energiegedrag-nl/needforheat-p1-base-hardware/docs/checks/4-gerber-netlist.txt

gerber primitives F 1854, B 426; copper islands F 94, B 45; plated holes 273
pads not on any copper: none
pads in board but not in schematic netlist: none
schematic nets checked: 47; derived copper nets: 47
OPENS: none
SHORTS: none
