energiegedrag-nl/needforheat-p1-base-hardware/docs/images/p1-base-v3-bottom.png

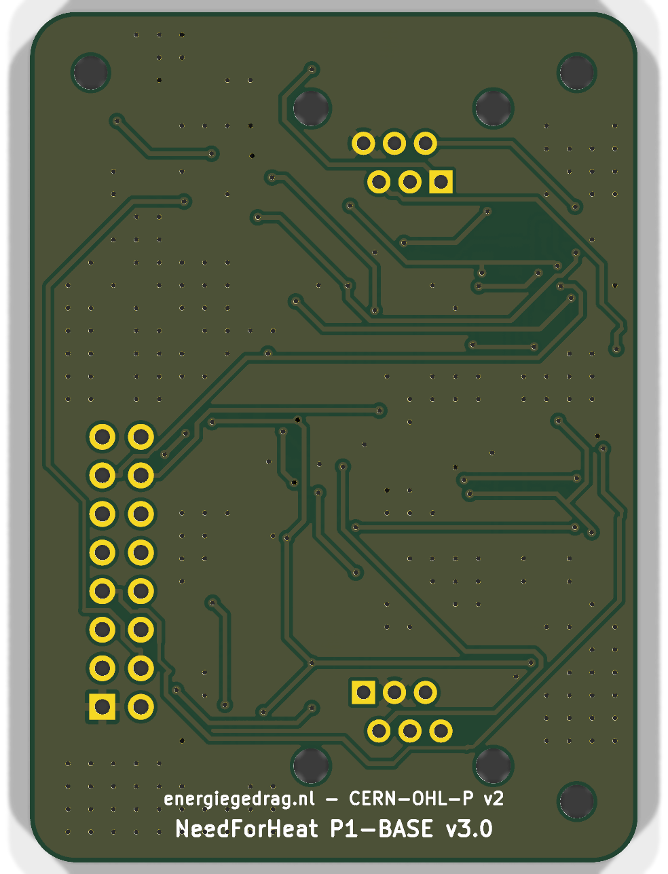
docs/images/p1-base-v3-bottom.png
