energiegedrag-nl/needforheat-p1-base-hardware/docs/images/p1-base-v3-side.png

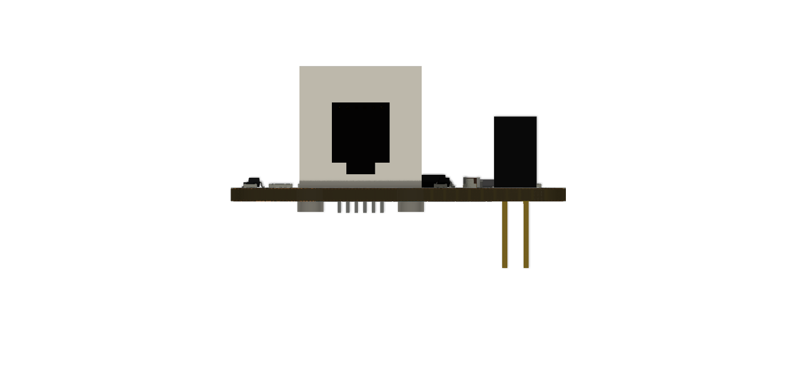
docs/images/p1-base-v3-side.png
