energiegedrag-nl/needforheat-p1-base-hardware/pcb/jlcpcb/BOM-needforheat-p1-base-hardware.csv

Comment | Designator | Footprint | LCSC
1u | C1,C3 | C_0603_1608Metric | C15849
100n | C2,C4,C6 | C_0603_1608Metric | C14663
22n | C7 | C_0603_1608Metric | C21122
10u | C8,C9 | C_0805_2012Metric | C15850
SMF5.0A | D1 | D_SMF | C193402
BAT54C | D2 | SOT-23 | C37704
PESD5V0S1BB | D3,D4,D5,D6 | D_SOD-523 | C2687128
1N5819WS | D7 | D_SOD-323 | C191023
CoreInk bus | J1 | CoreInk_Bus_2x08_P2.54mm | C72555
RJ12 to meter / RJ12 existing reader | J2,J3 | RJ25_Wayconn_MJEA-660X1_Horizontal | C77859
LED green | LED1 | LED_0603_1608Metric | C12624
LED yellow | LED2 | LED_0603_1608Metric | C2287
LED red | LED3 | LED_0603_1608Metric | C2286
AO3401A | Q1,Q3,Q6 | SOT-23 | C15127
2N7002 | Q2,Q4,Q5,Q7,Q8 | SOT-23 | C8545
10k | R1,R13,R32 | R_0603_1608Metric | C25804
100R | R2,R8,R16 | R_0603_1608Metric | C22775
1k | R3,R11,R25,R29 | R_0603_1608Metric | C21190
4k7 | R4 | R_0603_1608Metric | C23162
47R | R5 | R_0603_1608Metric | C23182
2k2 | R7,R31 | R_0603_1608Metric | C4190
100k | R9,R10,R12,R14,R21,R23,R26,R30 | R_0603_1608Metric | C25803
47k | R18,R24 | R_0603_1608Metric | C25819
68k | R19,R22 | R_0603_1608Metric | C23231
3k3 | R20 | R_0603_1608Metric | C22978
20k | R27,R28 | R_0603_1608Metric | C4184
74LVC1G14 | U1 | SOT-23-5 | C7835
TP4056 | U3 | SOIC-8-1EP_3.9x4.9mm_P1.27mm_EP2.29x3mm | C16581
