energiegedrag-nl/needforheat-p1-base-hardware/enclosure/fabrication/p1-base-kuip.step

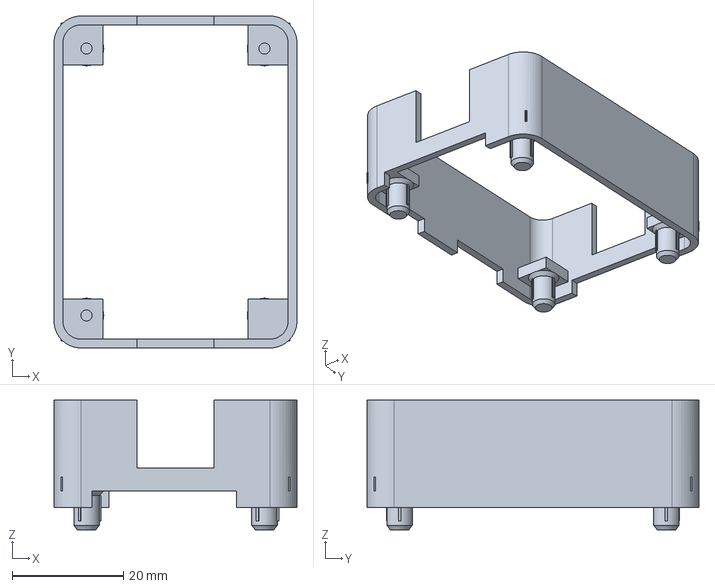
[picture p7: CAD file, 2026-11-14]
enclosure/fabrication/p1-base-kuip.step
43.7 x 59.7 x 23.3 mm
