energiegedrag-nl/needforheat-p1-base-hardware/enclosure/p1-base-v3-pcb.step

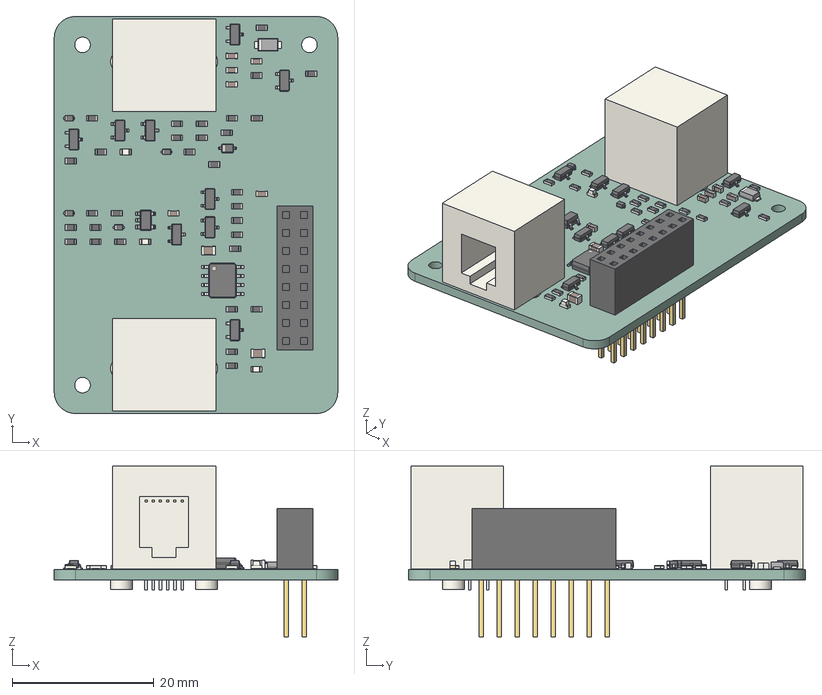
[picture p8: CAD file, 2026-11-14]
enclosure/p1-base-v3-pcb.step
40.0 x 56.0 x 24.1 mm
R_0603_1608Metric x 31
C_0603_1608Metric x 6
SOT-23 x 9
D_SOD_523 x 4
pins
D_SOD-323
C_0805_2012Metric x 2
LED_0603_1608Metric x 3
SOT-23-5
contacts x 2
legs x 2
posts x 2
D_SMF
SOIC-8-1EP_3.9x4.9mm_P1.27mm_EP2.29x3mm
needforheat-p1-base-hardware_PCB
