energiegedrag-nl/needforheat-p1-base-hardware/enclosure/fabrication/p1-base-lid.step

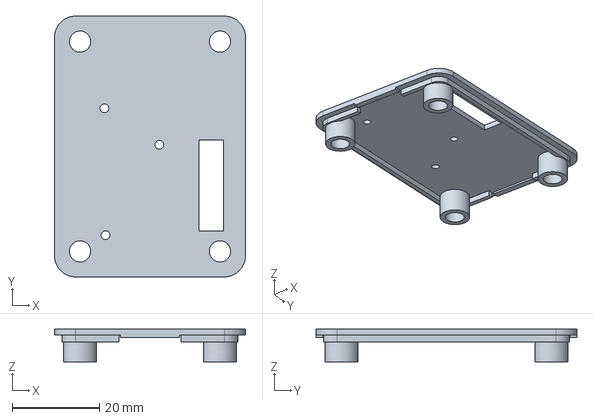
[picture p9: CAD file, 2026-11-14]
enclosure/fabrication/p1-base-lid.step
43.7 x 59.7 x 7.50 mm
