energiegedrag-nl/needforheat-p1-base-hardware/(list of files, cad)

Other CAD files:
enclosure/fabrication/p1-base-kuip.stl
enclosure/fabrication/p1-base-lid.stl
