energiegedrag-nl/needforheat-p1-base-hardware/docs/needforheat-p1-base-hardware-sch.pdf

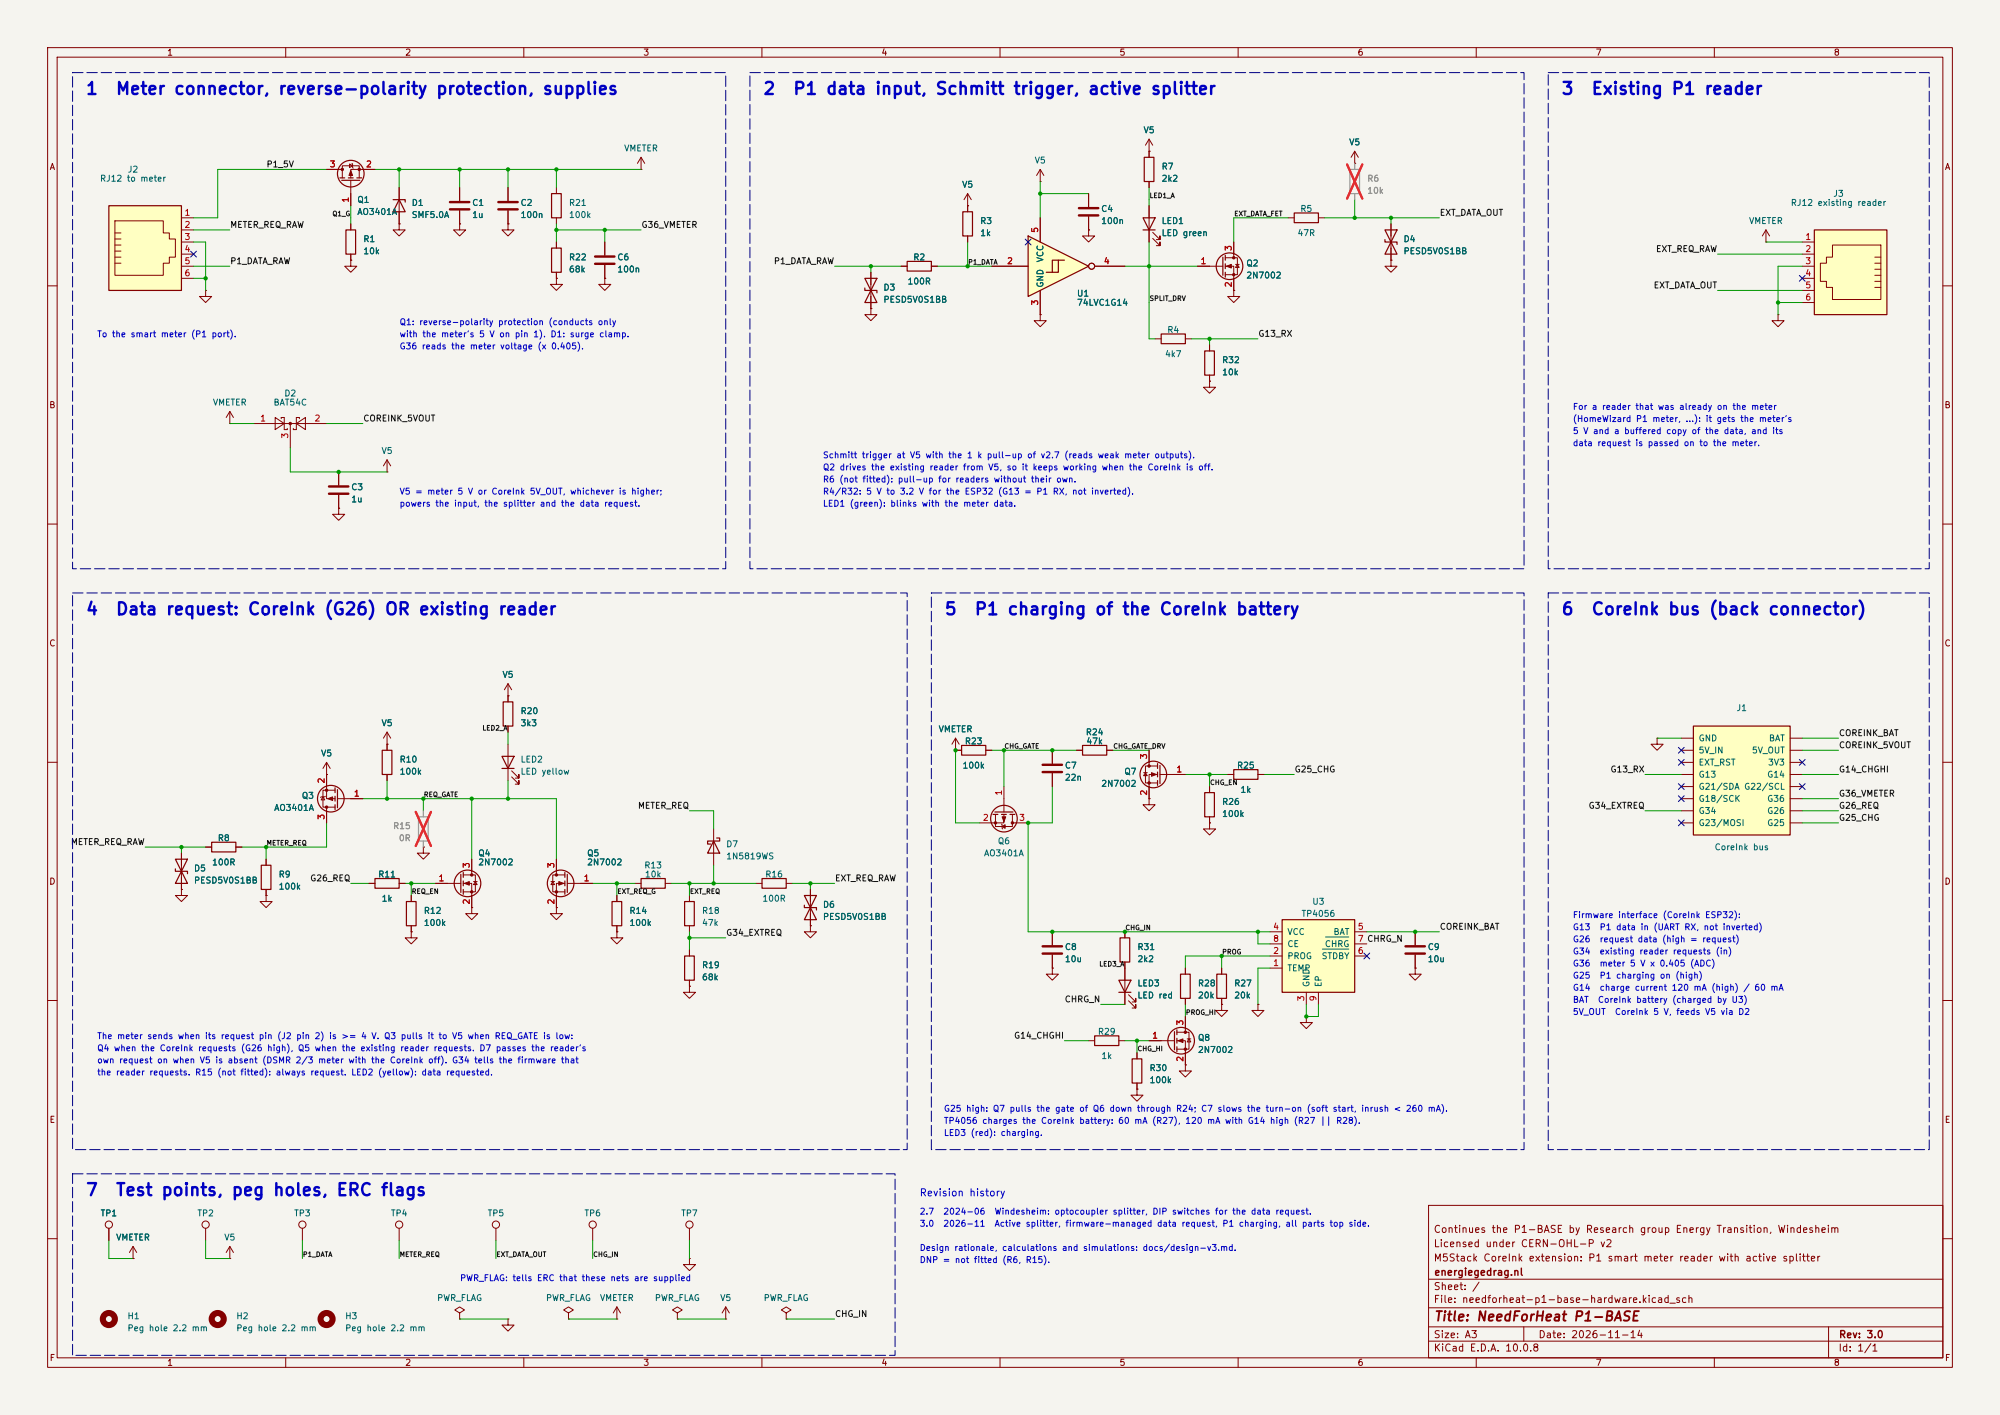
[picture p10: page 1]

R4/R32: 5 V to 3.2 V for the ESP32 (G13 = P1 RX, not inverted). Q1: reverse-polarity protection (conducts only with the meter's 5 V on pin 1). D1: surge clamp. G36 reads the meter voltage (x 0.405). V5 = meter 5 V or CoreInk 5V_OUT, whichever is higher; powers the input, the splitter and the data request.

To the smart meter (P1 port).

(HomeWizard P1 meter, ...): it gets the meter's For a reader that was already on the meter data request is passed on to the meter. 5 P1 charging of the CoreInk battery

5 V and a buffered copy of the data, and its G13 P1 data in (UART RX, not inverted) G26 request data (high = request) G34 existing reader requests (in) G36 meter 5 V x 0.405 (ADC) G25 P1 charging on (high) Firmware interface (CoreInk ESP32): G25 high: Q7 pulls the gate of Q6 down through R24; C7 slows the turn-on (soft start, inrush < 260 mA).

4 Data request: CoreInk (G26) OR existing reader

6 CoreInk bus (back connector)

Design rationale, calculations and simulations: docs/design-v3.md. LED3

G14 charge current 120 mA (high) / 60 mA

own request on when V5 is absent (DSMR 2/3 meter with the CoreInk off). G34 tells the firmware that
the reader requests. R15 (not fitted): always request. LED2 (yellow): data requested.

LED3 (red): charging. DNP = not fitted (R6, R15). TP4056 charges the CoreInk battery: 60 mA (R27), 120 mA with G14 high (R27 || R28).

7 Test points, peg holes, ERC flags

Revision history
2.7 2024-06 Windesheim: optocoupler splitter, DIP switches for the data request.
3.0 2026-11 Active splitter, firmware-managed data request, P1 charging, all parts top side.

Continues the P1-BASE by Research group Energy Transition, Windesheim
Licensed under CERN-OHL-P v2
M5Stack CoreInk extension: P1 smart meter reader with active splitter
energiegedrag.nl
Sheet: /
File: needforheat-p1-base-hardware.kicad_sch
Title: NeedForHeat P1-BASE

Size: A3 | Rev: 3.0 | F Date: 2026-11-14
KiCad E.D.A. 10.0.8 | Id: 1/1
