energiegedrag-nl/needforheat-p1-base-hardware/docs/needforheat-p1-base-hardware-pcb-bottom.pdf

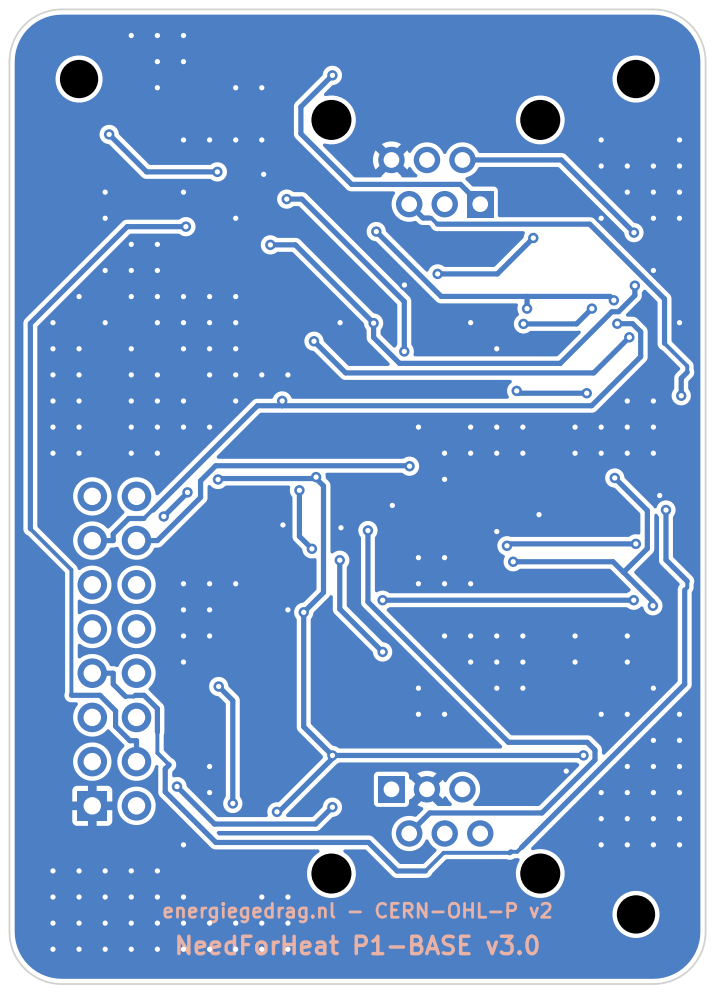
[picture p11: page 1]

energiegedrag.nl - CERN-OHL-P v2 NeedForHeat P1-BASE v3.0
