energiegedrag-nl/needforheat-p1-base-hardware/docs/needforheat-p1-base-hardware-pcb.pdf

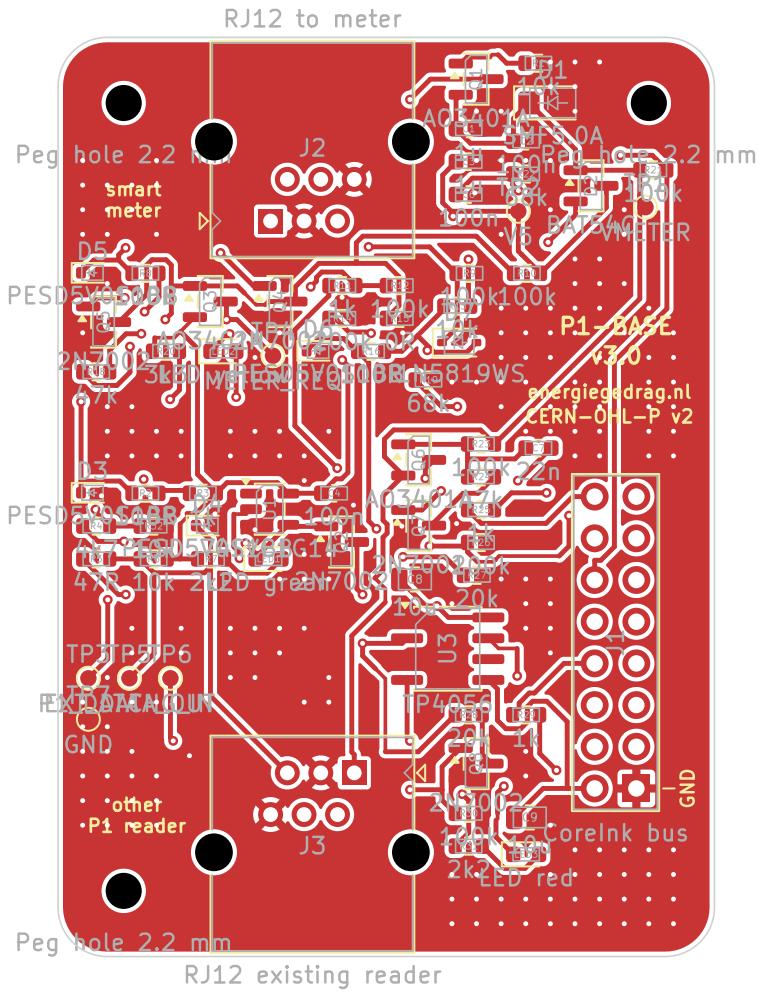
[picture p12: page 1]
