energiegedrag-nl/needforheat-p1-base-hardware/(list of files, drawings)

Other design files:
enclosure/pcb_features.json
