energiegedrag-nl/needforheat-p1-base-hardware/pcb/needforheat-p1-base-hardware.kicad_pcb

## KiCad design pcb/needforheat-p1-base-hardware.kicad_pcb (2026-11-14)

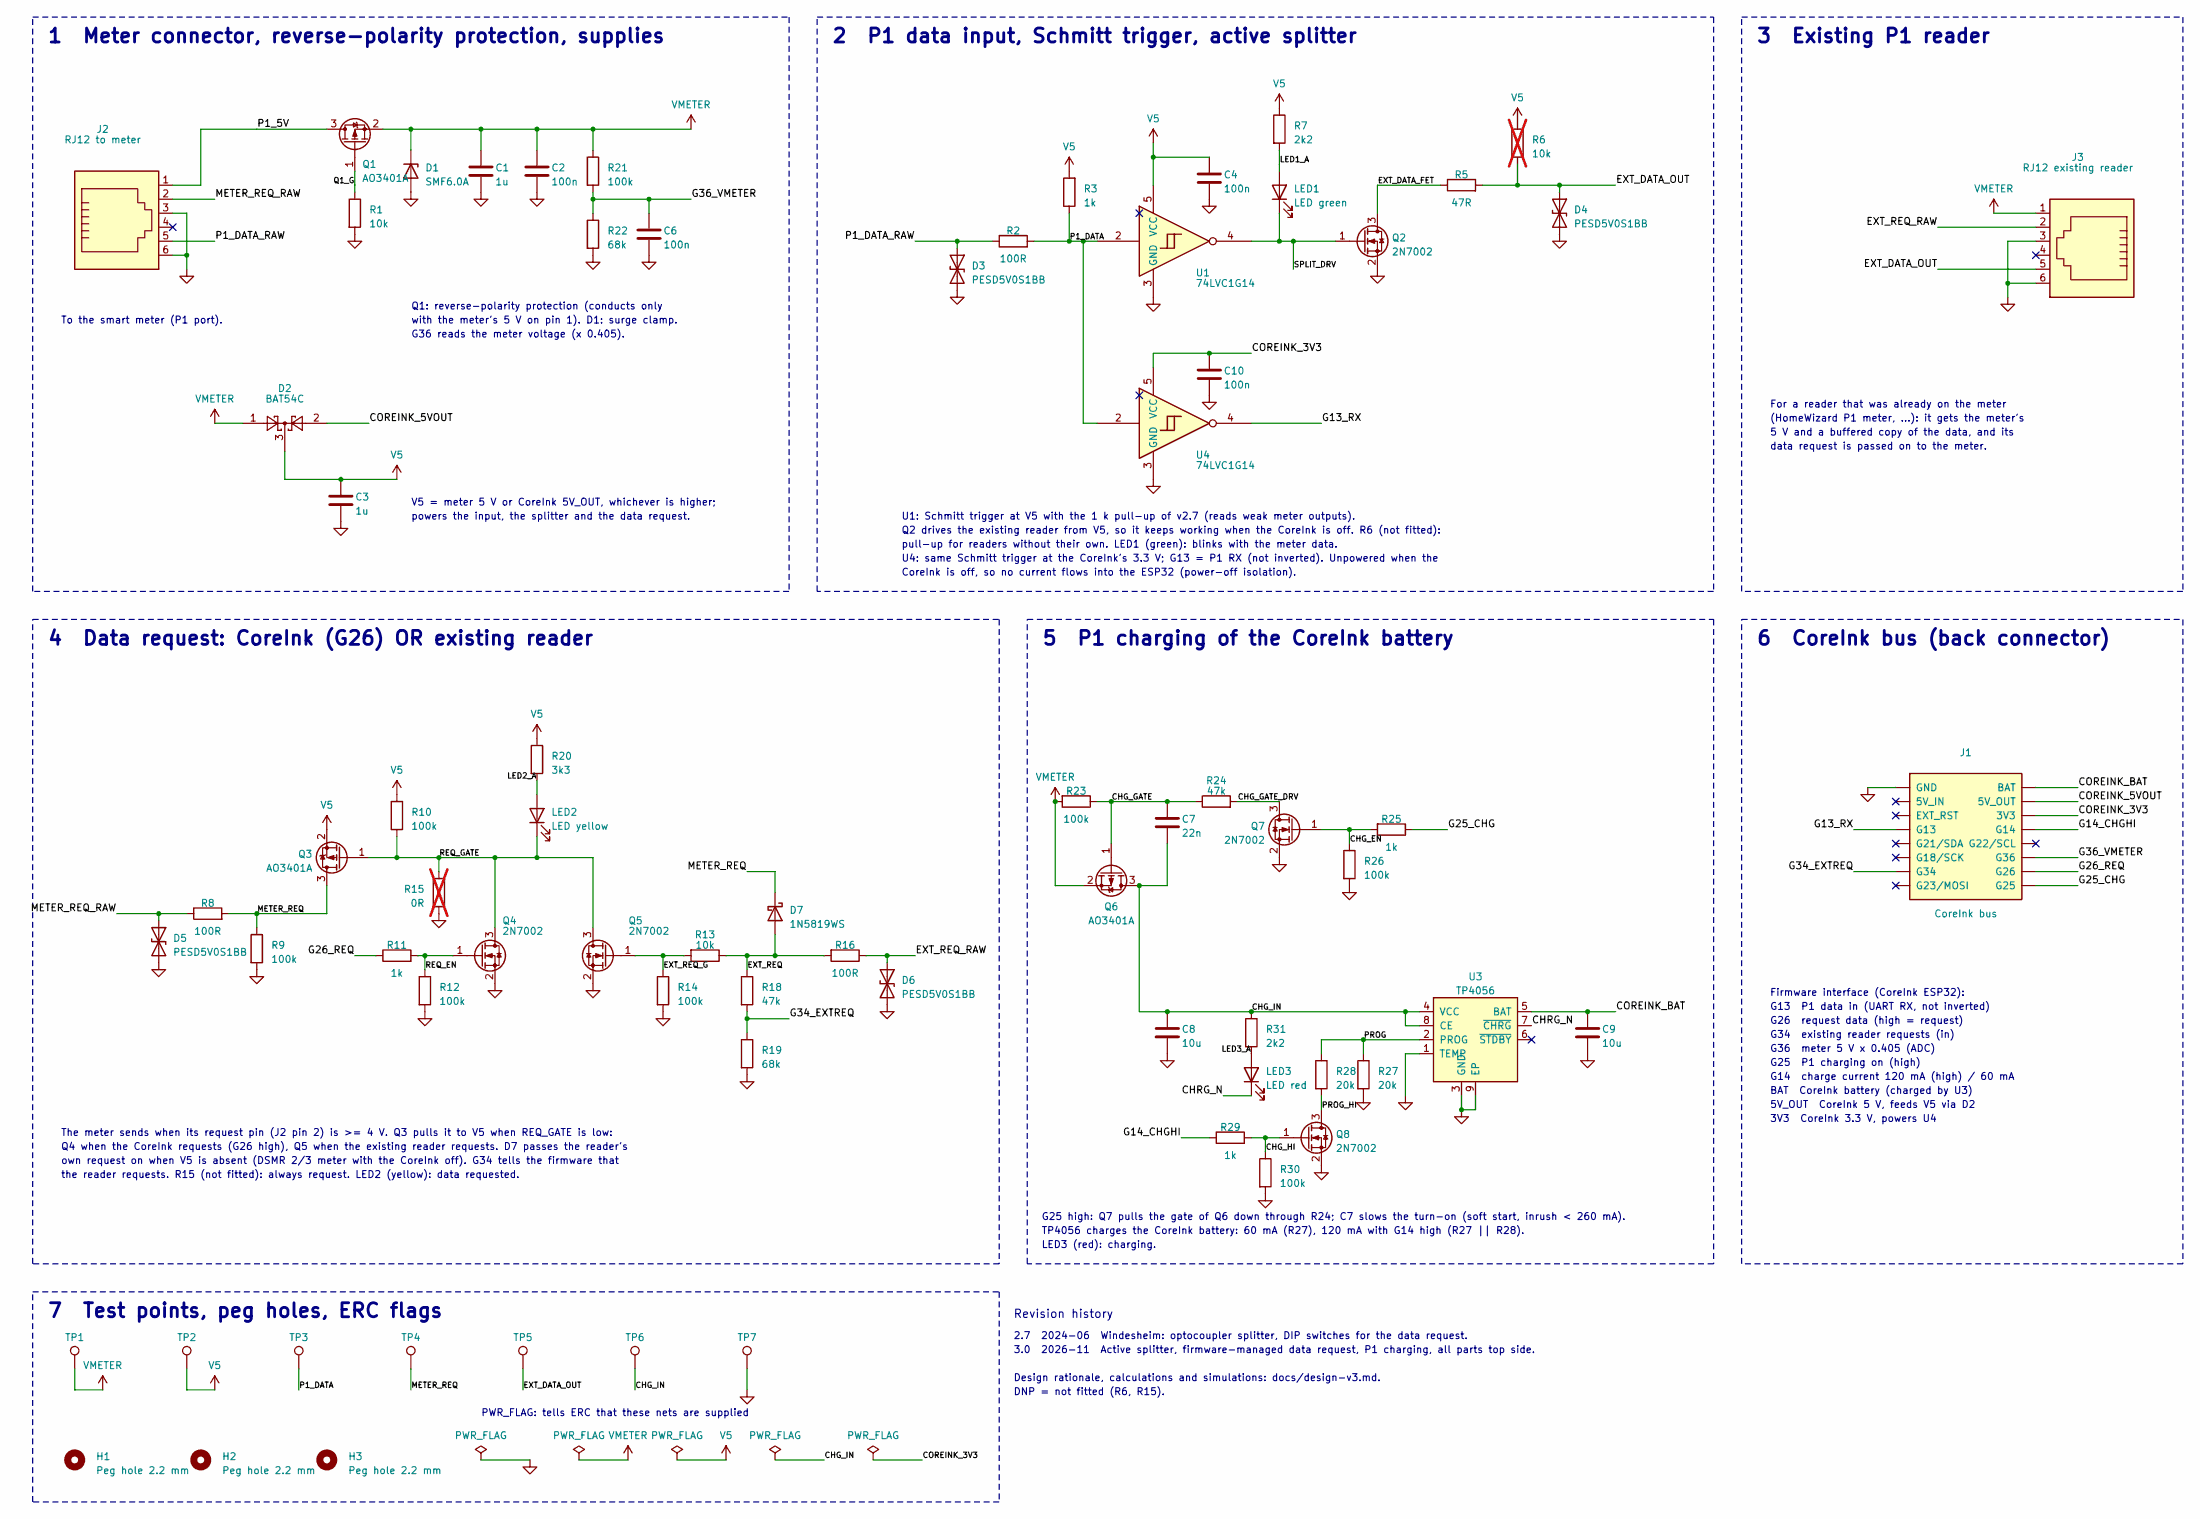
[picture p13: schematic needforheat-p1-base-hardware.kicad_sch, NeedForHeat P1-BASE]

Parts:
C1, C3: 1u; C_0603_1608Metric; LCSC C15849
C2, C4, C6, C10: 100n; C_0603_1608Metric; LCSC C14663
C7: 22n; C_0603_1608Metric; LCSC C21122
C8, C9: 10u; C_0805_2012Metric; LCSC C15850
D1: SMF6.0A; D_SMF; LCSC C178260
D2: BAT54C; SOT-23; LCSC C37704
D3, D4, D5, D6: PESD5V0S1BB; D_SOD-523; LCSC C2687128
D7: 1N5819WS; D_SOD-323; LCSC C191023
H1, H2, H3: Peg hole 2.2 mm; MountingHole_2.2mm_M2
J1: CoreInk bus; CoreInk_Bus_2x08_P2.54mm; LCSC C72555
J2: RJ12 to meter; RJ12_EVERCOM_5301-6P6C; LCSC C3097716
J3: RJ12 existing reader; RJ12_EVERCOM_5301-6P6C; LCSC C3097716
LED1: LED green; LED_0603_1608Metric; LCSC C12624
LED2: LED yellow; LED_0603_1608Metric; LCSC C2287
LED3: LED red; LED_0603_1608Metric; LCSC C2286
Q1, Q3, Q6: AO3401A; SOT-23; LCSC C15127
Q2, Q4, Q5, Q7, Q8: 2N7002; SOT-23; LCSC C8545
R1, R13: 10k; R_0603_1608Metric; LCSC C25804
R2, R8, R16: 100R; R_0603_1608Metric; LCSC C22775
R3, R11, R25, R29: 1k; R_0603_1608Metric; LCSC C21190
R5: 47R; R_0603_1608Metric; LCSC C23182
R6: 10k; R_0603_1608Metric; LCSC C25804; not fitted
R7, R31: 2k2; R_0603_1608Metric; LCSC C4190
R9, R10, R12, R14, R21, R23, R26, R30: 100k; R_0603_1608Metric; LCSC C25803
R15: 0R; R_0603_1608Metric; LCSC C21189; not fitted
R18, R24: 47k; R_0603_1608Metric; LCSC C25819
R19, R22: 68k; R_0603_1608Metric; LCSC C23231
R20: 3k3; R_0603_1608Metric; LCSC C22978
R27, R28: 20k; R_0603_1608Metric; LCSC C4184
TP1: VMETER; TestPoint_Pad_D1.0mm
TP2: V5; TestPoint_Pad_D1.0mm
TP3: P1_DATA; TestPoint_Pad_D1.0mm
TP4: METER_REQ; TestPoint_Pad_D1.0mm
TP5: EXT_DATA_OUT; TestPoint_Pad_D1.0mm
TP6: CHG_IN; TestPoint_Pad_D1.0mm
TP7: GND; TestPoint_Pad_D1.0mm
U1, U4: 74LVC1G14; SOT-23-5; LCSC C7835
U3: TP4056; SOIC-8-1EP_3.9x4.9mm_P1.27mm_EP2.29x3mm; LCSC C16581

Connections:
/CHG_EN: Q7.1 (G), R25.2, R26.1
/CHG_GATE: C7.1, Q6.1 (G), R23.1, R24.1
/CHG_GATE_DRV: Q7.3 (D), R24.2
/CHG_HI: Q8.1 (G), R29.2, R30.1
/CHG_IN: C7.2, C8.1, Q6.3 (D), R31.1, TP6.1, U3.4 (VCC), U3.8 (CE)
/CHRG_N: LED3.1 (K), U3.7 (~CHRG)
/COREINK_3V3: C10.1, J1.3V3, U4.5 (VCC)
/COREINK_5VOUT: D2.2, J1.5VOUT (5V_OUT)
/COREINK_BAT: C9.1, J1.BAT, U3.5 (BAT)
/EXT_DATA_FET: Q2.3 (D), R5.1
/EXT_DATA_OUT: D4.1 (A1), J3.5, R5.2, R6.1, TP5.1
/EXT_REQ: D7.2 (A), R13.1, R16.2, R18.1
/EXT_REQ_G: Q5.1 (G), R13.2, R14.1
/EXT_REQ_RAW: D6.1 (A1), J3.2, R16.1
/G13_RX: J1.G13, U4.4
/G14_CHGHI: J1.G14, R29.1
/G25_CHG: J1.G25, R25.1
/G26_REQ: J1.G26, R11.1
/G34_EXTREQ: J1.G34, R18.2, R19.1
/G36_VMETER: C6.1, J1.G36, R21.2, R22.1
/LED1_A: LED1.2 (A), R7.2
/LED2_A: LED2.2 (A), R20.2
/LED3_A: LED3.2 (A), R31.2
/METER_REQ: D7.1 (K), Q3.3 (D), R8.2, R9.1, TP4.1
/METER_REQ_RAW: D5.1 (A1), J2.2, R8.1
/P1_5V: J2.1, Q1.3 (D)
/P1_DATA: R2.2, R3.1, TP3.1, U1.2, U4.2
/P1_DATA_RAW: D3.1 (A1), J2.5, R2.1
/PROG: R27.1, R28.1, U3.2 (PROG)
/PROG_HI: Q8.3 (D), R28.2
/Q1_G: Q1.1 (G), R1.1
/REQ_EN: Q4.1 (G), R11.2, R12.1
/REQ_GATE: LED2.1 (K), Q3.1 (G), Q4.3 (D), Q5.3 (D), R10.1, R15.1
/SPLIT_DRV: LED1.1 (K), Q2.1 (G), U1.4
GND: C1.2, C2.2, C3.2, C4.2, C6.2, C8.2, C9.2, C10.2, D1.2 (A), D3.2 (A2), D4.2 (A2), D5.2 (A2), D6.2 (A2), J1.GND, J2.3, J2.6, J3.3, J3.6, Q2.2 (S), Q4.2 (S), Q5.2 (S), Q7.2 (S), Q8.2 (S), R1.2, R9.2, R12.2, R14.2, R15.2, R19.2, R22.2, R26.2, R27.2, R30.2, TP7.1, U1.3 (GND), U3.1 (TEMP), U3.3 (GND), U3.9 (EP), U4.3 (GND)
V5: C3.1, C4.1, D2.3, Q3.2 (S), R3.2, R6.2, R7.1, R10.2, R20.1, TP2.1, U1.5 (VCC)
VMETER: C1.1, C2.1, D1.1 (K), D2.1, J3.1, Q1.2 (S), Q6.2 (S), R21.1, R23.2, TP1.1

Notes on the sheet:
1 Meter connector, reverse-polarity protection, supplies
To the smart meter (P1 port).
Q1: reverse-polarity protection (conducts only
with the meter's 5 V on pin 1). D1: surge clamp.
G36 reads the meter voltage (x 0.405).
V5 = meter 5 V or CoreInk 5V_OUT, whichever is higher;
powers the input, the splitter and the data request.
2 P1 data input, Schmitt trigger, active splitter
U1: Schmitt trigger at V5 with the 1 k pull-up of v2.7 (reads weak meter outputs).
Q2 drives the existing reader from V5, so it keeps working when the CoreInk is off. R6 (not fitted):
pull-up for readers without their own. LED1 (green): blinks with the meter data.
U4: same Schmitt trigger at the CoreInk's 3.3 V; G13 = P1 RX (not inverted). Unpowered when the
CoreInk is off, so no current flows into the ESP32 (power-off isolation).
3 Existing P1 reader
For a reader that was already on the meter
(HomeWizard P1 meter, ...): it gets the meter's
5 V and a buffered copy of the data, and its
data request is passed on to the meter.
4 Data request: CoreInk (G26) OR existing reader
The meter sends when its request pin (J2 pin 2) is >= 4 V. Q3 pulls it to V5 when REQ_GATE is low:
Q4 when the CoreInk requests (G26 high), Q5 when the existing reader requests. D7 passes the reader's
own request on when V5 is absent (DSMR 2/3 meter with the CoreInk off). G34 tells the firmware that
the reader requests. R15 (not fitted): always request. LED2 (yellow): data requested.
5 P1 charging of the CoreInk battery
G25 high: Q7 pulls the gate of Q6 down through R24; C7 slows the turn-on (soft start, inrush < 260 mA).
TP4056 charges the CoreInk battery: 60 mA (R27), 120 mA with G14 high (R27 || R28).
LED3 (red): charging.
6 CoreInk bus (back connector)
Firmware interface (CoreInk ESP32):
G13 P1 data in (UART RX, not inverted)
G26 request data (high = request)
G34 existing reader requests (in)
G36 meter 5 V x 0.405 (ADC)
G25 P1 charging on (high)
G14 charge current 120 mA (high) / 60 mA
BAT CoreInk battery (charged by U3)
5V_OUT CoreInk 5 V, feeds V5 via D2
3V3 CoreInk 3.3 V, powers U4
7 Test points, peg holes, ERC flags
PWR_FLAG: tells ERC that these nets are supplied
Revision history
2.7 2024-06 Windesheim: optocoupler splitter, DIP switches for the data request.
3.0 2026-11 Active splitter, firmware-managed data request, P1 charging, all parts top side.
Design rationale, calculations and simulations: docs/design-v3.md.
DNP = not fitted (R6, R15).

Board: 2 copper layers, 72 parts (0 on the bottom side), 37 nets, no tracks yet.
