energiegedrag-nl/needforheat-p1-base-hardware/(commit log)

2026-11-14 P1-BASE v3.0 design: active splitter, firmware-managed data request, P1 charging
    New version of the CoreInk extension (design, not yet built or tested):
    - active P1 splitter in hardware, powered by the meter (replaces the
    optocoupler); data request by the CoreInk and by the existing reader
    (PMOS OR, no DIP switches), read-back of the reader's request
    - same meter front end as v2.7 (1 k pull-up, Schmitt trigger)
    - charging of the CoreInk battery from DSMR 5 meters at 60/120 mA
    (TP4056 on BAT) with a Miller soft start below the fold-back limit
    - reverse-polarity, TVS and ESD protection; meter voltage on G36
    - 40 x 56 mm board in the CoreInk outline, all parts on top, stacking
    header so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
    [BOM-needforheat-p1-base-hardware.csv, needforheat-p1-base-hardware.kicad_pcb, needforheat-p1-base-hardware.kicad_sch, p1-base-kuip.step, p1-base-kuip.stl, p1-base-lid.step, p1-base-lid.stl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]
2026-11-14 P1-BASE v3: 3D models, JLCPCB placement fixes, new socket labels
    - Silkscreen labels "smart meter" and "other P1 reader" (README follows).
    - Simple 3D models for the RJ12 jack and the CoreInk stacking header
    (tools/gen_3d_models.py), so renders and the board STEP show all parts.
    RJ12 dimensions from LCSC data for C77859 (14.5 mm tall); the enclosure
    openings follow.
    - CPL corrections for JLCPCB (export_fab.JLC_CORR): SOT-23/SOT-23-5 +180,
    SOIC-8 +270, RJ12 offset to the pin centre +90, CoreInk header +90.
    Checked in the JLCPCB placement preview. BOM lines with the same LCSC
    part are merged.
    - design-v3.md: JLCPCB quote (5 boards: EUR 43.68 excl. shipping/VAT),
    HASL needed for E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
    [BOM-needforheat-p1-base-hardware.csv, needforheat-p1-base-hardware.kicad_pcb, p1-base-kuip.step, p1-base-kuip.stl, p1-base-lid.step, p1-base-lid.stl, p1-base-v3-pcb.step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]
2026-11-14 Independent design checks; lid clears the RJ12 jacks
    tools/checks/run_checks.py runs four checks that use other data or software
    than the tools that made the design; reports in docs/checks/:
    1. LCSC (JLCPCB) footprints placed from our CPL land pad-for-pad on ours,
    with matching pin functions.
    2. Worst-case net voltages against every pin's absolute maximum, plus
    back-feeding into a switched-off CoreInk.
    4. Connectivity rebuilt from the gerbers alone equals the schematic netlist.
    5. 3D fit of CoreInk, populated board, tray, lid and RJ12 plugs.
    Fix from check 5: the lid's lip and tongues reached into the jack tops.
    Findings documented in docs/design-v3.md section 12 (G13 back-feed, TVS
    s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
    [p1-base-kuip.step, p1-base-lid.step, p1-base-lid.stl]
2026-11-14 Readable schematic: blocks, wires and power symbols
    gen_schematic.py now draws the circuit instead of labelling every pin:
    seven framed blocks with numbered titles, real wires inside each block,
    power symbols for VMETER, V5 and GND, labels only between blocks, all
    references and values horizontal, notes, firmware interface and revision
    history on the sheet. Conventions taken from the NeedForHeat and Twomes
    hardware repositories (docs/design-v3.md section 13).
    The circuit description stays the source of truth: after writing, the
    script exports the netlist with kicad-cli and fails if it differs. Custom
    symbols are on the 2.54 mm grid. tools/sync_pcb_nets.py renamed the three
    power nets in the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
    [needforheat-p1-base-hardware.kicad_pcb, needforheat-p1-base-hardware.kicad_sch]
2026-11-14 Schematic: U4 drives G13 from the CoreInk 3V3, D1 SMF6.0A; redesign notes
    - U4 (second 74LVC1G14, C7835, with C10) replaces the R4/R32 divider: no
    current into a switched-off CoreInk (finding A of the independent checks).
    - D1 SMF6.0A (C178260): stand-off above any meter voltage (finding B).
    - Voltage check updated; CoreInk schematic facts (BAT = SYS_BAT, 5V_OUT,
    3V3) recorded in section 10.
    - PCB tools: island vias must also land in the other layer's GND pour (one
    had shorted G34), a fallback for small fragments, and a placement variant
    switch; tools/pcb_cleanup.py removes misplaced and dangling vias; the
    router is capped at 2 GB.
    - design-v3.md section 9a lists the decided redesi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
    [needforheat-p1-base-hardware.kicad_sch]
2026-11-14 Enclosure: LEGO posts, lid like the CoreInk's back, gap 2.5 mm, no steel discs
    - Four LEGO posts under the tray (7 mm, crush ribs, flared root) in the
    CoreInk's LEGO through holes: longer than the 6 mm bus pins, so they
    guide the module and protect the pins in transport. Replaces the nocks.
    - The lid repeats the CoreInk's back: four LEGO holes (tubes under the
    lid) and a cut-out for a raised bus socket flush with the lid, so one
    BatteryBASE fits a CoreInk and a P1-BASE alike.
    - Gap CoreInk-PCB 2.5 mm (RJ12 leads at most 1.9 mm below the board).
    - Steel-disc pockets removed; corner blocks now joined to the wall (they
    were separate solids before).
    - design-v3.md section 9a and enclos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
    [p1-base-kuip.step, p1-base-kuip.stl, p1-base-lid.step, p1-base-lid.stl]
2026-11-14 RJ12 jacks: EVERCOM 5301 (11.45 mm), centred; new placement
    - J2/J3: EVERCOM 5301-6P6C (C3097716, in JLCPCB stock), 11.45 mm high
    instead of 14.5 mm. Footprint p1base:RJ12_EVERCOM_5301-6P6C taken from
    LCSC (no CPL correction needed); approximate 3D model generated.
    - Both jacks centred on the long axis, openings 0.5 mm past the edges, so
    the device hangs straight.
    - New placement blocks around the deeper jacks; the four corners stay free
    for the enclosure posts and lid tubes; silkscreen labels next to the jacks.
    - Enclosure: jack openings and lid height follow the 11.45 mm jacks.
    - design-v3.md section 9a point 8.
    The board is placed but not yet routed (DRC reports unrouted nets unt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
    [needforheat-p1-base-hardware.kicad_pcb, needforheat-p1-base-hardware.kicad_sch, p1-base-kuip.step, p1-base-kuip.stl, p1-base-lid.step, p1-base-lid.stl, pcb_features.json]
2026-11-14 J1: Samtec ESQ-108-24-G-D raised socket; lid flush with it
    The P1-BASE repeats the CoreInk's back, so the BatteryBASE fits both. J1 is
    a Samtec ESQ-108-24-G-D (JLCPCB C21241050, pre-order): socket top 13.59 mm
    above the board, tail 9.65 mm below the board's top (Samtec ESQ table 1),
    8.51 mm deep socket. With the 2.5 mm gap its pins go 5.5 mm into the
    CoreInk. The lid's outer face is now flush with the socket top (0.74 mm
    above the 11.45 mm RJ12 jacks). 3D model, BOM field and design-v3.md
    section 9a updated.
    Claude-Session: https://claude.ai/code/session_01JjieB3TySUaqzkNY4HzyQW
    [needforheat-p1-base-hardware.kicad_sch, p1-base-kuip.step, p1-base-kuip.stl, p1-base-lid.step, p1-base-lid.stl]
